robotikklinja/Flow-and-level-control/LWETankExample/lwe1/img/A18FD00E.png

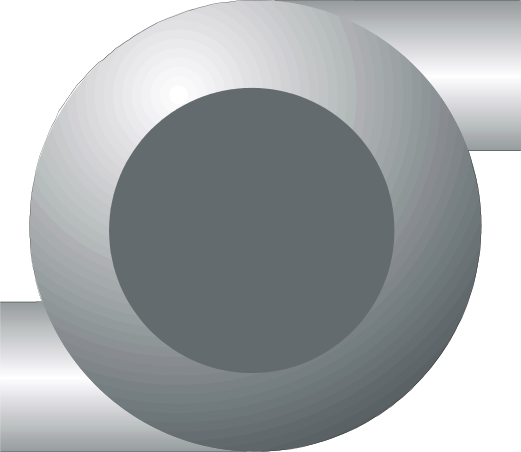
LWETankExample/lwe1/img/A18FD00E.png
