robotikklinja/Flow-and-level-control/LWETankExample/lwe1/img/EAA03FDC.png

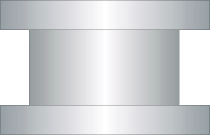
LWETankExample/lwe1/img/EAA03FDC.png
