robotikklinja/Flow-and-level-control/koblingsskjema_vann_stasjon.pdf

Projekttitel: Vann-stasjon | Sagsnr.: | Projektrev.: | Side 10
Kunde: Kuben VGS | DCC: | | Målestok: 1:1
Sidetitel: Forside | Tegningsnr.: | Siderev.: | Forrige side:
Filnavn: koblingsskjema_recovery | Konstr. (projekt/side): Jakob R | Sidst udskrevet: 07.03.2024 | Næste side: 20
Sideref.: | Godk. (dato/init): | Sidst rettet: 07.03.2024 | Antal sider ialt: 41

PCSCHEMATIC Automation

PCSCHEMATIC Automation Skoleversjon. Må ikke anvendes kommersielt.

# Vann-stasjon

# Vann-stasjon

# Special_Card side 250 - 250

# P&ID_Externt_etc side 300 - 301

# 10 Layout side 400 - 400

# Analog_Output

# Analog_Input

# Digital_Output

# Digital_Input

# Safety

# HMI

# Hovedstrøm_Fordeling

123456789

side 100 - 101

side 200 - 200

side 210 - 210

side 220 - 220

side 230 - 230

side 240 - 240

PCSCHEMATIC Automation Skoleversjon. Må ikke anvendes kommersielt.

# Vann-stasjon

# Graf Plan

Lister | 11
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
side 500 - 552

side 600 - 610

PCSCHEMATIC Automation Skoleversjon. Må ikke anvendes kommersielt.

Projekttitel: Vann-stasjon | Sagsnr.: | Projektrev.: | Side 30
Kunde: Kuben VGS | DCC: | | Målestok: 1:1
Indholdsfortegnelse
koblingsskjema_recovery | Jakob R | 07.03.2024 | 40
| | 14.12.2020 | 41

PCSCHEMATIC Automation

PCSCHEMATIC Automation Skoleversjon. Må ikke anvendes kommersielt.

Titel | Revision | Sidste rettelsestid | Sidenr. | Titel | Revision | Sidste rettelsestid | Sidenr.
| | | 40

100

101

200

210

220

230

Projektinfo

Hovedstrøm_Fordeling

Hovedfordeling

Fordeling

HMI

Safety

Digital_Input

Digital_Output

Analog_Input

28.03.2016 21:04:02

14.12.2020 09:54:18

25.09.2017 20:18:40

14.12.2020 09:25:04

14.12.2020 09:25:20

14.12.2020 09:25:04

25.09.2017 19:56:04

240

250

300

Analog_Output

Special_Card

P&ID_Externt_etc

P&ID_Prosesskjema

25.09.2017 19:56:12

25.09.2017 19:56:12

01.04.2016 09:41:30

301

400

500

510

Reguleringssløyfe

Layout

Arrangementstegning

Lister

Stykkliste (BOM-Liste, Bill Of Materials)

Komponentliste -B300..P300

28.03.2016 23:24:46

14.12.2020 09:27:34

14.12.2020 09:40:14

14.12.2020 09:40:14

Kabelliste | 28.03.2016 21:10:52 | 520
Rekkeklemmeliste Ekstern / Intern | 14.12.2020 09:26:10 | 530
PLS liste | 14.12.2020 09:26:10 | 540

550

600

610

Sidebemerkninger

Graf Plan

Tilordningsliste (Grafisk Klemplan)

Kabelplan

14.12.2020 10:00:56

28.03.2016 21:11:18

28.03.2016 21:11:28

Projekttitel: Vann-stasjon | Sagsnr.: | Projektrev.: | Side 40
Kunde: Kuben VGS | DCC: | | Målestok: 1:1
Projektinfo
28.03.2016 | 41 PCSCHEMATIC Automation

PCSCHEMATIC Automation Skoleversjon. Må ikke anvendes kommersielt.

### Projektinfo

Her er der plads til at beskrive forskellige udgangspunkter for projektet.

### Bemærkninger

### Referencebetegnelser

### Dedikerede lederfarver for forskellige potentialer/signaler Navngivning og nummerering Opmærkning af komponenter, kabler og ledninger Stregtyper Referencebetegnelser

og meget andet ...

# Hovedstrøm_Fordeling

### - 102 Side 100

PCSCHEMATIC Automation Skoleversjon. Må ikke anvendes kommersielt.

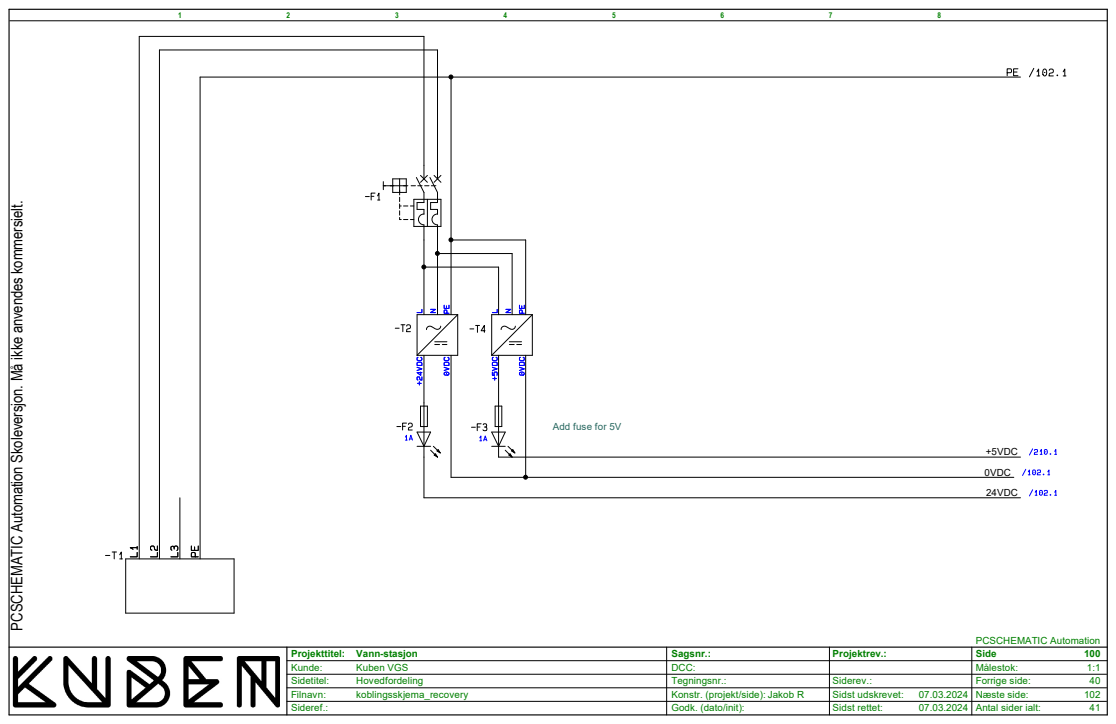
[picture p3: page 7]
PCSCHEMATIC Automation; 24VDC; 0VDC; +5VDC

PCSCHEMATIC Automation Skoleversjon. Må ikke anvendes kommersielt. 1 2

Add fuse for 5V

Projekttitel: Vann-stasjon | Sagsnr.: | Projektrev.: | Side 100
Kunde: Kuben VGS | DCC: | | Målestok: 1:1

Hovedfordeling

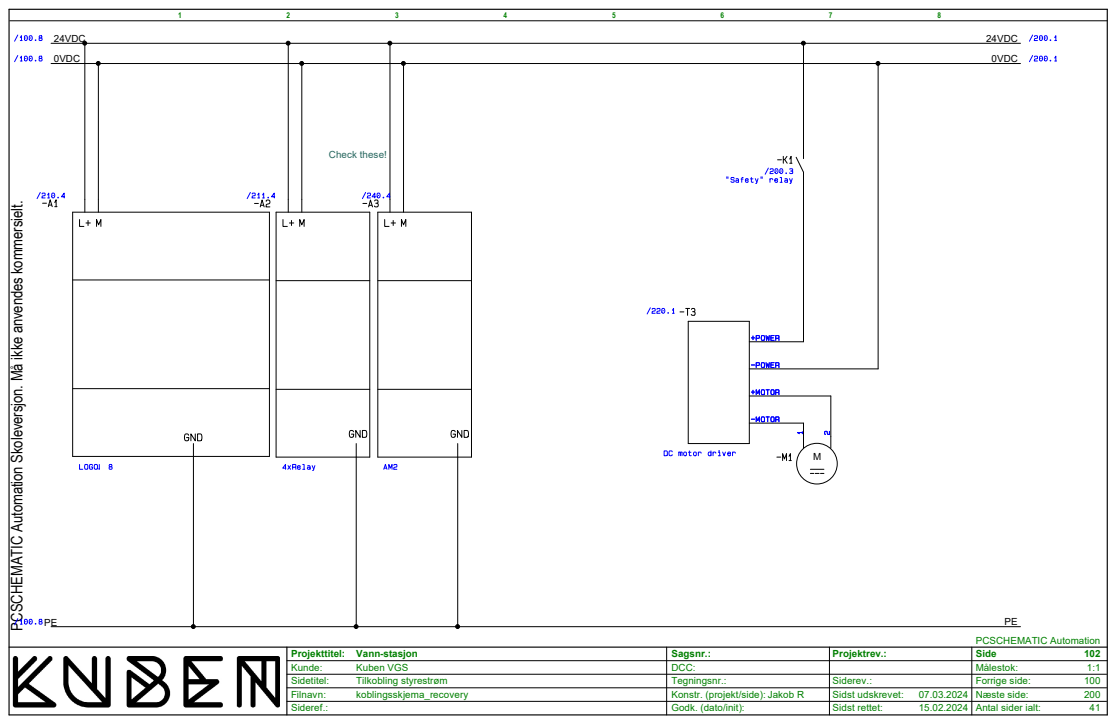
[picture p4: page 8]
PCSCHEMATIC Automation; 24VDC; 0VDC; Check these!

PCSCHEMATIC Automation Skoleversjon. Må ikke anvendes kommersielt. 1 2

Projekttitel: Vann-stasjon | Sagsnr.: | Projektrev.: | Side 102
Kunde: Kuben VGS | DCC: | | Målestok: 1:1

Tilkobling styrestrøm

# HMI

PCSCHEMATIC Automation Skoleversjon. Må ikke anvendes kommersielt.

# Safety

### - 200 Side 200

PCSCHEMATIC Automation Skoleversjon. Må ikke anvendes kommersielt.

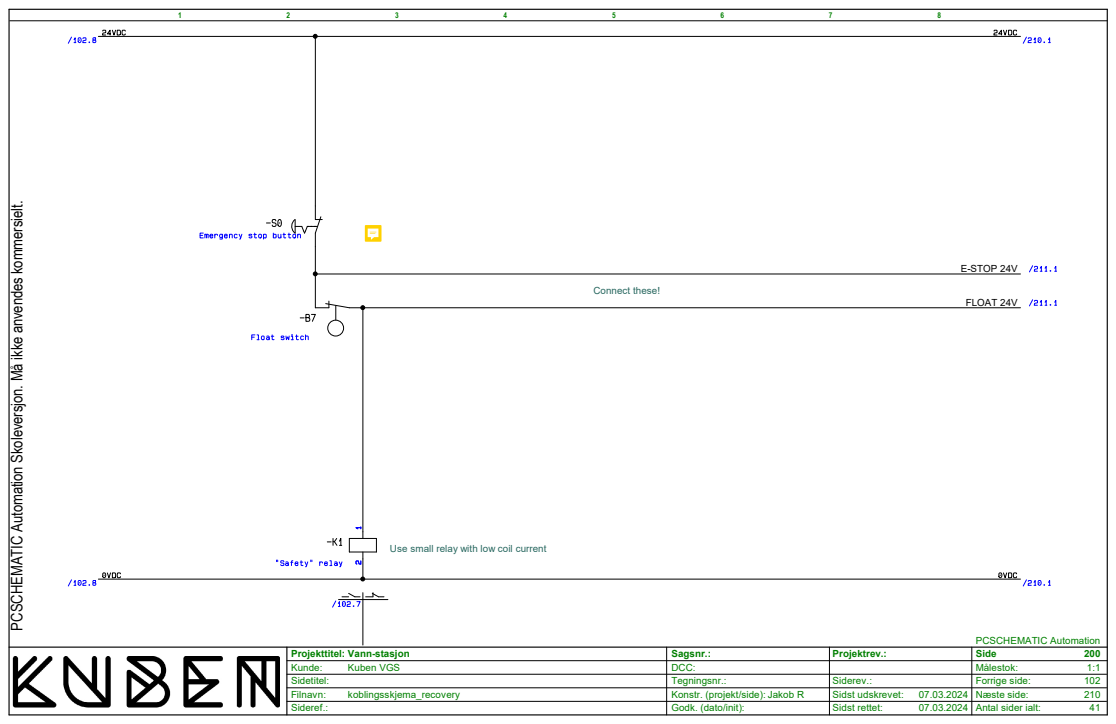
[picture p5: page 11]
PCSCHEMATIC Automation; E-STOP 24V; FLOAT 24V; Connect these!

PCSCHEMATIC Automation Skoleversjon. Må ikke anvendes kommersielt. 1 2

Use small relay with low coil current

Projekttitel: Vann-stasjon | Sagsnr.: | Projektrev.: | Side 200
Kunde: Kuben VGS | DCC: | | Målestok: 1:1

# Digital_Input

### - 211 Side 210

PCSCHEMATIC Automation Skoleversjon. Må ikke anvendes kommersielt.

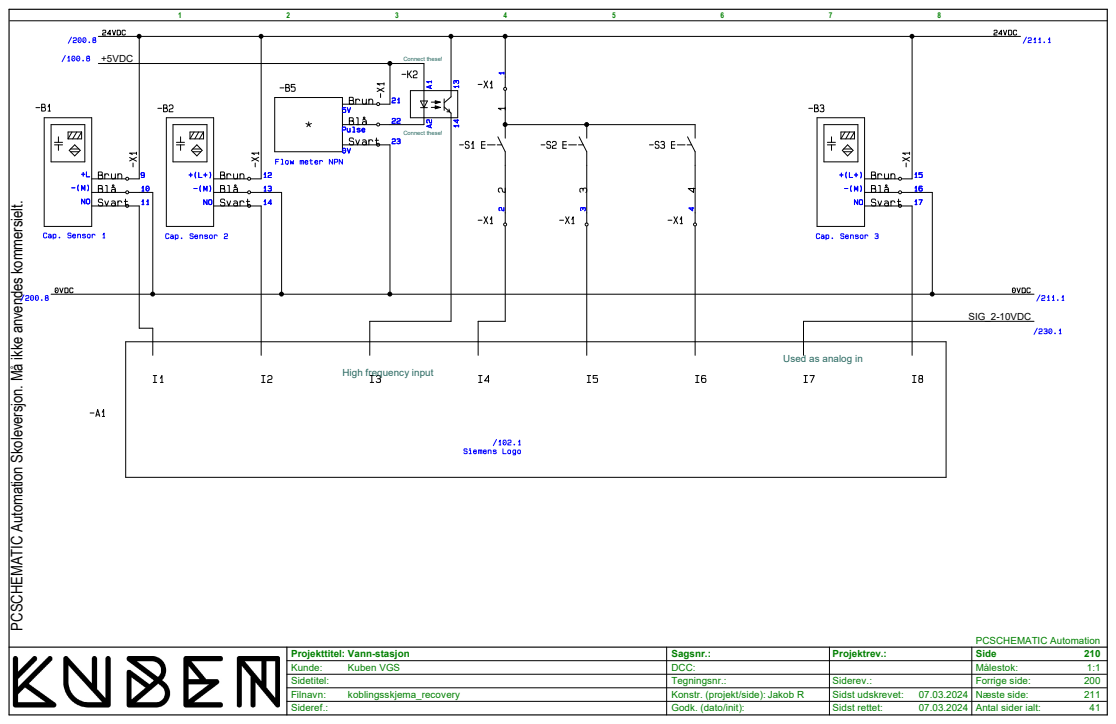
[picture p6: page 13]
PCSCHEMATIC Automation; SIG_2-10VDC; +5VDC; Connect these!

PCSCHEMATIC Automation Skoleversjon. Må ikke anvendes kommersielt. 1 2

Used as analog in

High frequency input

Projekttitel: Vann-stasjon | Sagsnr.: | Projektrev.: | Side 210
Kunde: Kuben VGS | DCC: | | Målestok: 1:1

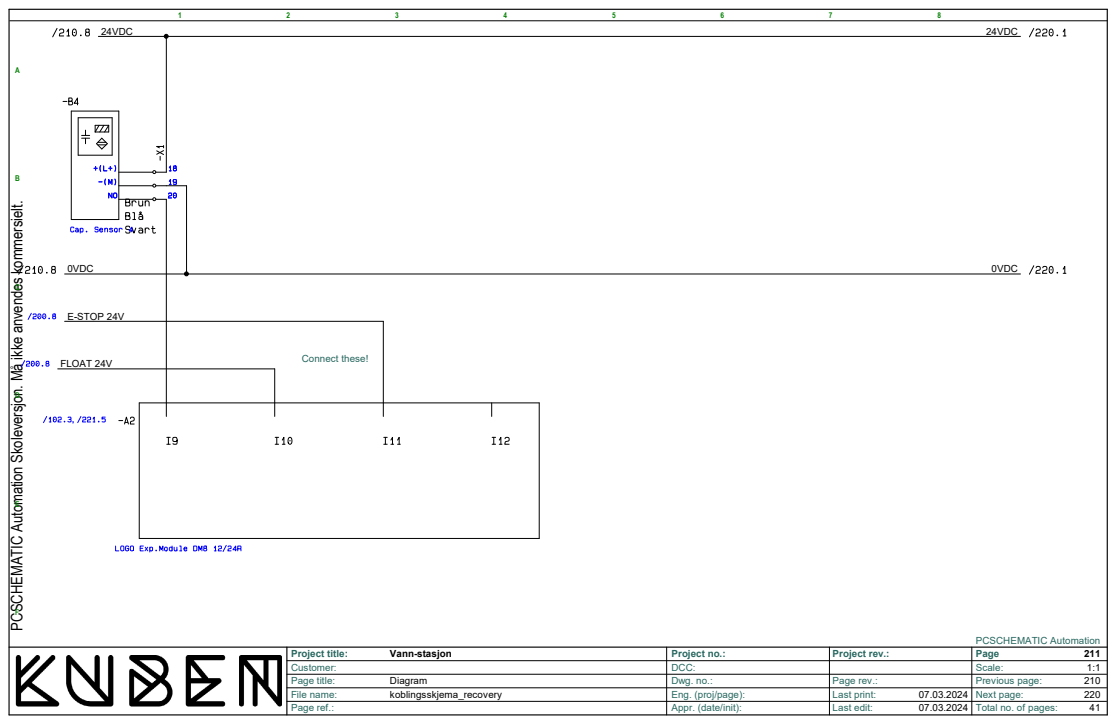
[picture p7: page 14]
PCSCHEMATIC Automation; ABCDEF; 24VDC; 0VDC; FLOAT 24V; E-STOP 24V; Connect these!

PCSCHEMATIC Automation Skoleversjon. Må ikke anvendes kommersielt. 1 2

Project title: Vann-stasjon | Project no.: | Project rev.: | Page 211
Customer: | DCC: | | Scale: 1:1
Page title: Diagram | Dwg. no.: | Page rev.: | Previous page:
File name: | Eng. (proj/page): | Last print: | Next page:
Page ref.: | Appr. (date/init): | Last edit: 07.03.2024 | Total no. of pages: 41

# Digital_Output

### - 221 Side 220

PCSCHEMATIC Automation Skoleversjon. Må ikke anvendes kommersielt.

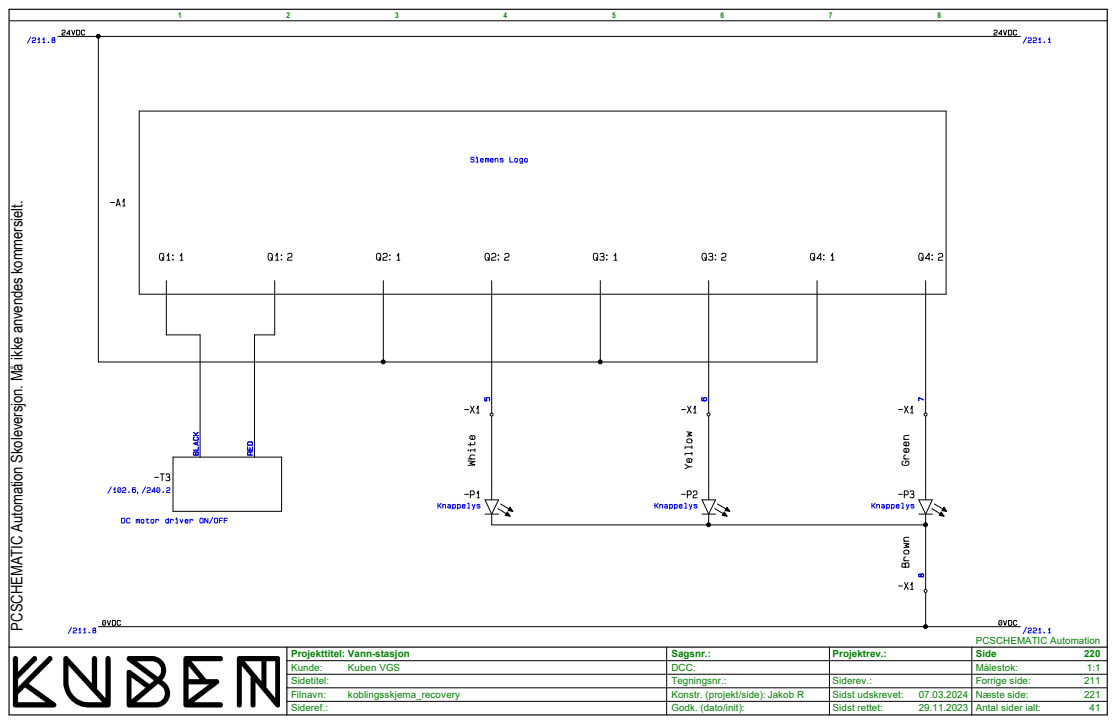
[picture p8: page 16]
PCSCHEMATIC Automation

PCSCHEMATIC Automation Skoleversjon. Må ikke anvendes kommersielt. 1 2

Projekttitel: Vann-stasjon | Sagsnr.: | Projektrev.: | Side 220
Kunde: Kuben VGS | DCC: | | Målestok: 1:1

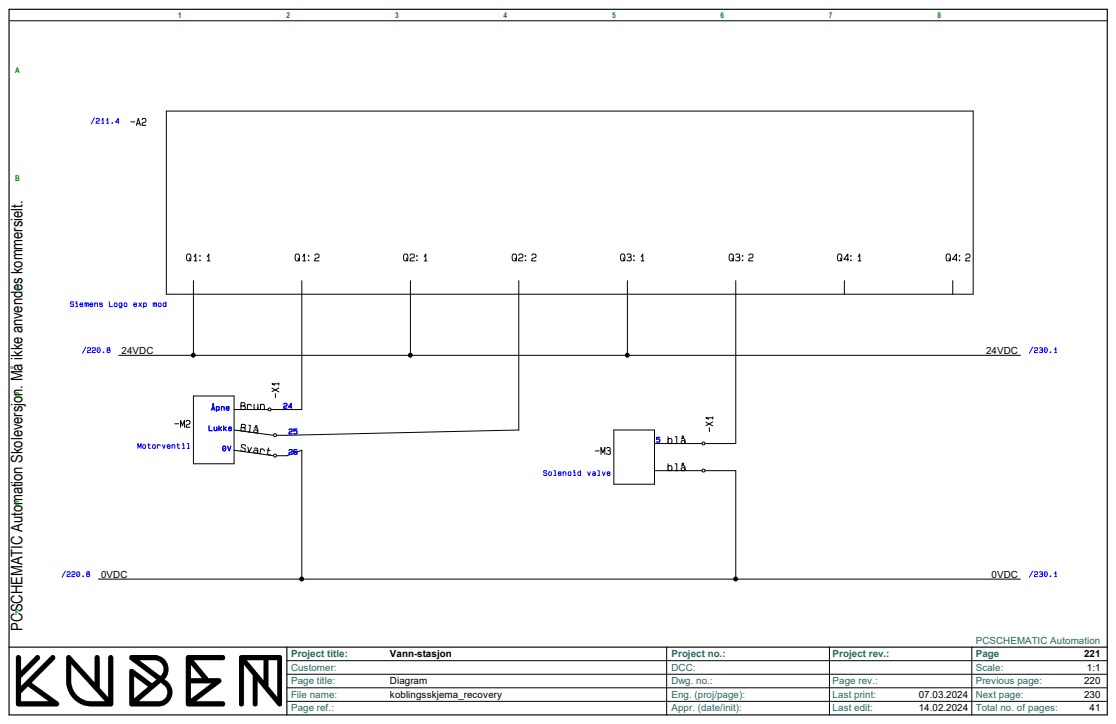
[picture p9: page 17]
PCSCHEMATIC Automation; ABCDEF; 24VDC; 0VDC

PCSCHEMATIC Automation Skoleversjon. Må ikke anvendes kommersielt. 1 2

Project title: Vann-stasjon | Project no.: | Project rev.: | Page 221
Customer: | DCC: | | Scale: 1:1
Page title: Diagram | Dwg. no.: | Page rev.: | Previous page:
File name: | Eng. (proj/page): | Last print: | Next page:
Page ref.: | Appr. (date/init): | Last edit: 14.02.2024 | Total no. of pages: 41

# Analog_Input

### - 230 Side 230

PCSCHEMATIC Automation Skoleversjon. Må ikke anvendes kommersielt.

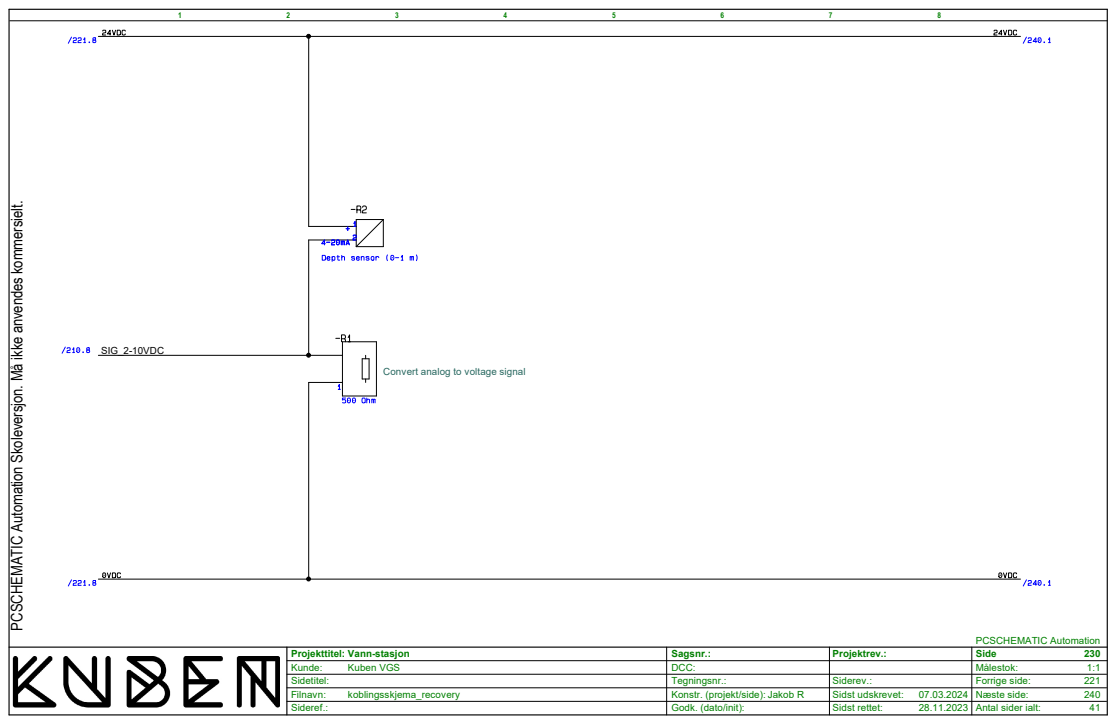
[picture p10: page 19]
PCSCHEMATIC Automation; SIG_2-10VDC

PCSCHEMATIC Automation Skoleversjon. Må ikke anvendes kommersielt. 1 2

Convert analog to voltage signal

Projekttitel: Vann-stasjon | Sagsnr.: | Projektrev.: | Side 230
Kunde: Kuben VGS | DCC: | | Målestok: 1:1

# Analog_Output

### - 240 Side 240

PCSCHEMATIC Automation Skoleversjon. Må ikke anvendes kommersielt.

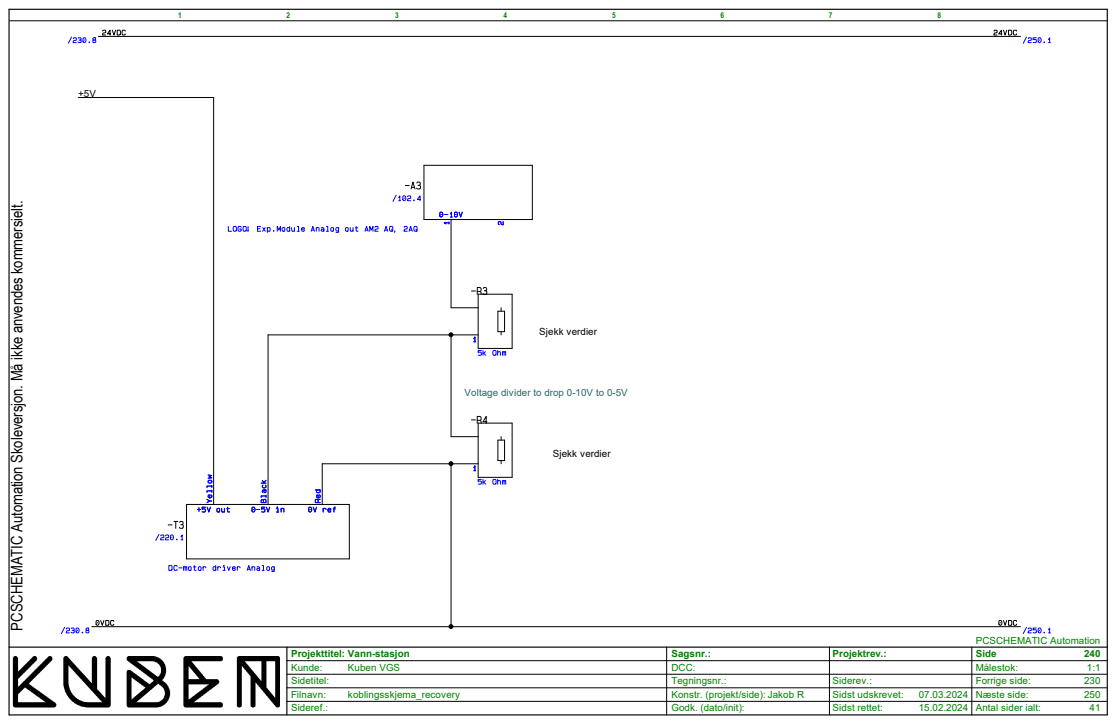
[picture p11: page 21]
PCSCHEMATIC Automation; Sjekk verdier

PCSCHEMATIC Automation Skoleversjon. Må ikke anvendes kommersielt. 1 2

Voltage divider to drop 0-10V to 0-5V

Projekttitel: Vann-stasjon | Sagsnr.: | Projektrev.: | Side 240
Kunde: Kuben VGS | DCC: | | Målestok: 1:1

# Special_Card

### - 250 Side 250

PCSCHEMATIC Automation Skoleversjon. Må ikke anvendes kommersielt.

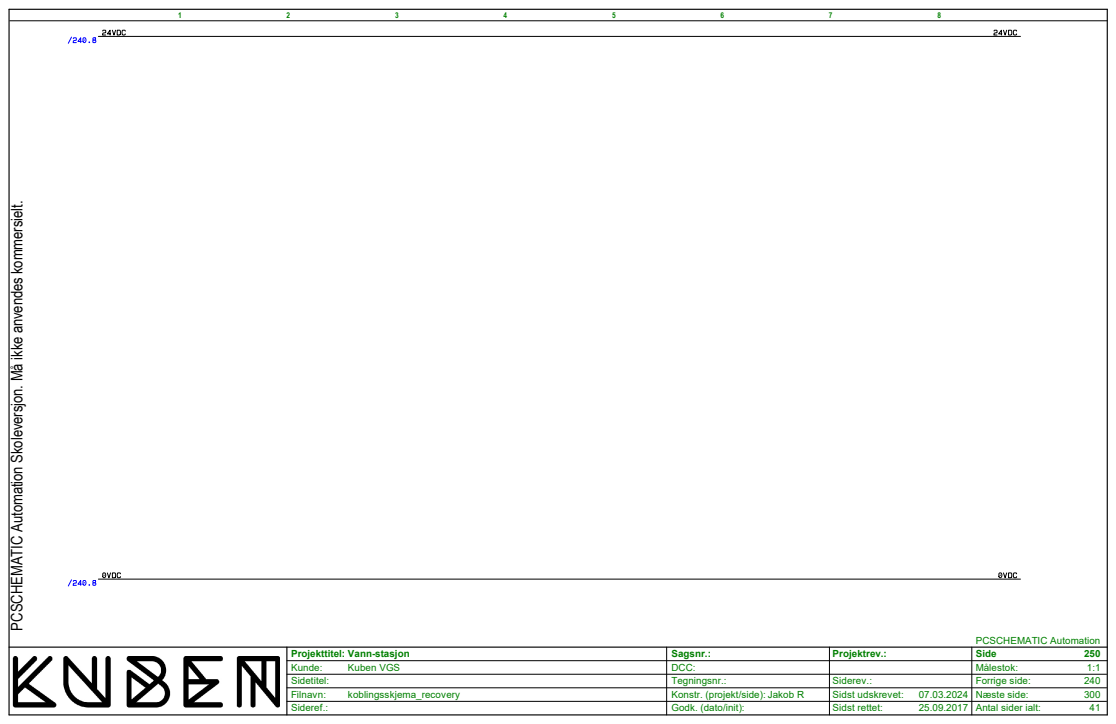
[picture p12: page 23]
PCSCHEMATIC Automation

PCSCHEMATIC Automation Skoleversjon. Må ikke anvendes kommersielt. 1 2

Projekttitel: Vann-stasjon | Sagsnr.: | Projektrev.: | Side 250
Kunde: Kuben VGS | DCC: | | Målestok: 1:1

# P&ID_Externt_etc

### - 301 Side 300

PCSCHEMATIC Automation Skoleversjon. Må ikke anvendes kommersielt.

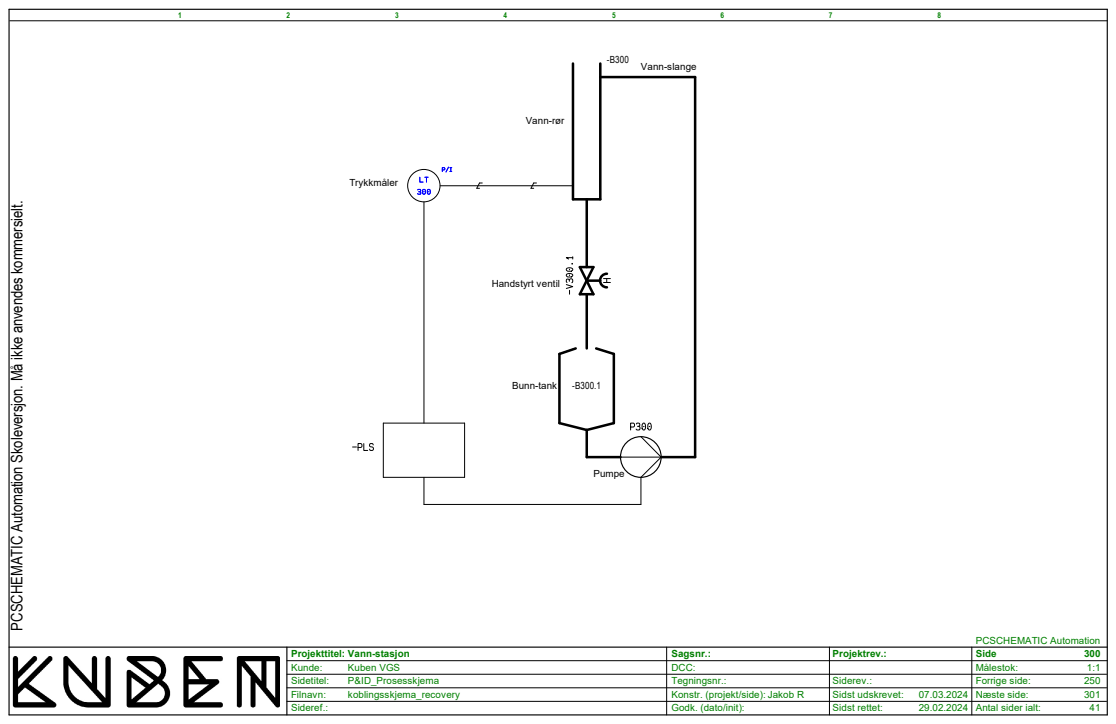
[picture p13: page 25]
PCSCHEMATIC Automation; Bunn-tank; Vann-rør; Trykkmåler; Handstyrt ventil; Vann-slange; Pumpe

PCSCHEMATIC Automation Skoleversjon. Må ikke anvendes kommersielt. 1 2

Projekttitel: Vann-stasjon | Sagsnr.: | Projektrev.: | Side 300
Kunde: Kuben VGS | DCC: | | Målestok: 1:1

P&ID_Prosesskjema

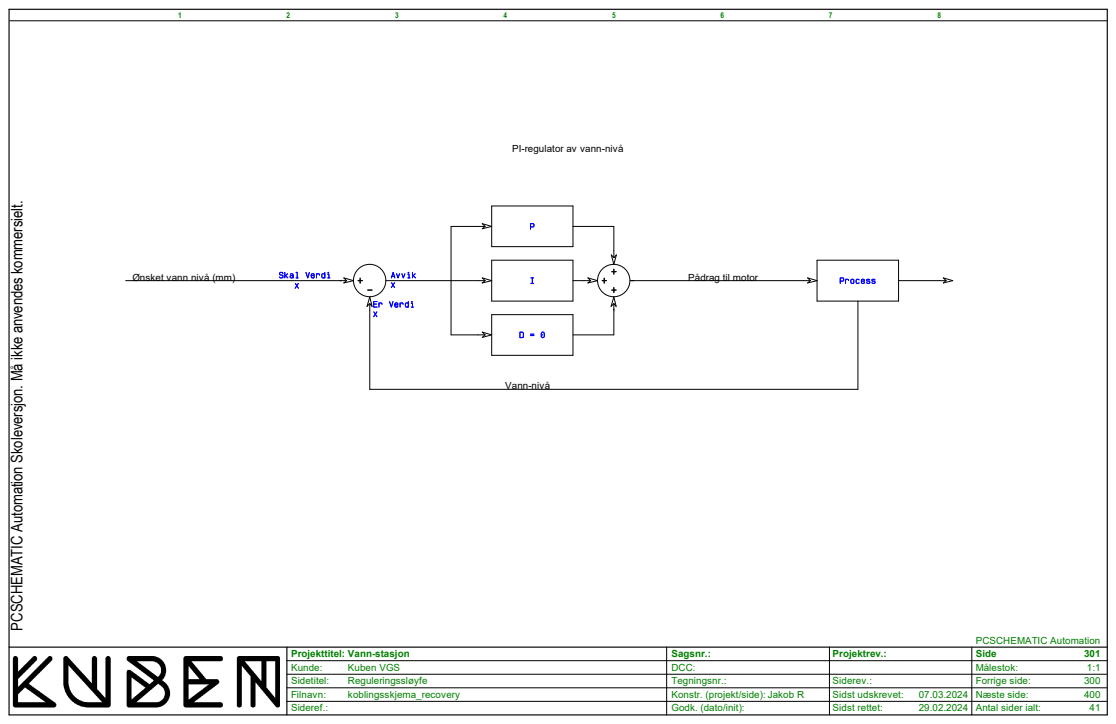
[picture p14: page 26]
PCSCHEMATIC Automation; Vann-nivå; Ønsket vann nivå (mm); Pådrag til motor

PI-regulator av vann-nivå

PCSCHEMATIC Automation Skoleversjon. Må ikke anvendes kommersielt.

Projekttitel: Vann-stasjon | Sagsnr.: | Projektrev.: | Side 301
Kunde: Kuben VGS | DCC: | | Målestok: 1:1

Reguleringssløyfe
