robotikklinja/Flow-and-level-control/LWETankExample/lwe1/img/2D491AB6.png

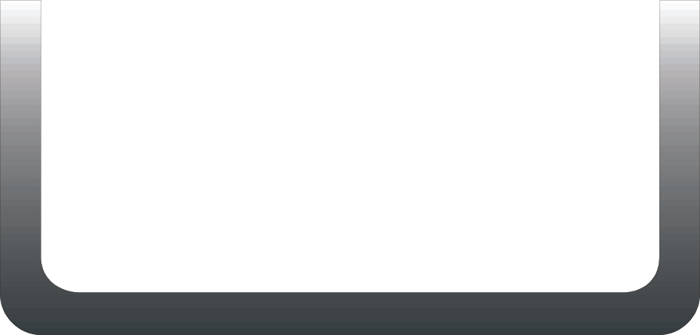
LWETankExample/lwe1/img/2D491AB6.png
