robotikklinja/Flow-and-level-control/LWETankExample/lwe1/img/38A8DEAD.png

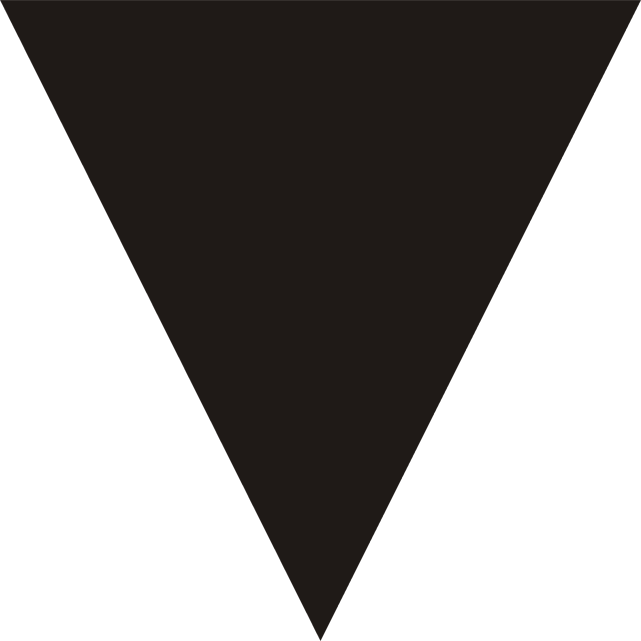
LWETankExample/lwe1/img/38A8DEAD.png
