robotikklinja/Flow-and-level-control/3D_prints/Valve_latch_main.stl

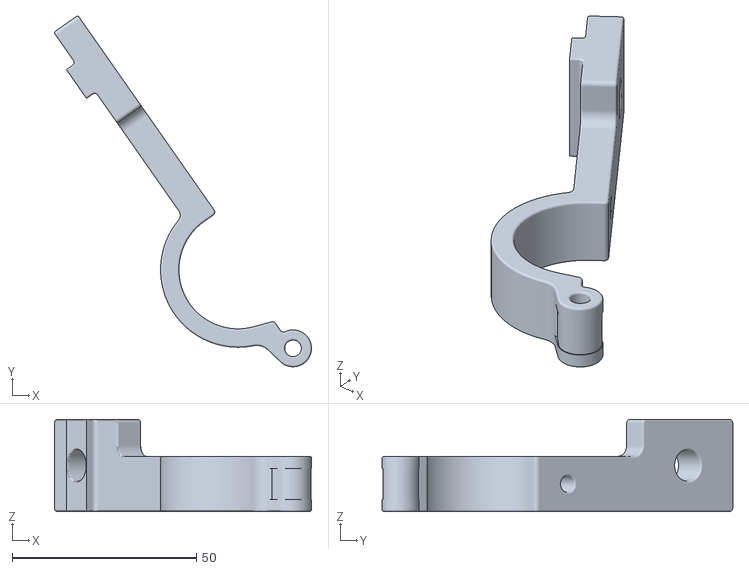
[picture p17: CAD file, 2023-11-13]
3D_prints/Valve_latch_main.stl
69.7 x 95.0 x 25.0
