robotikklinja/Flow-and-level-control/Sensor holder fløde regulering v1.stl

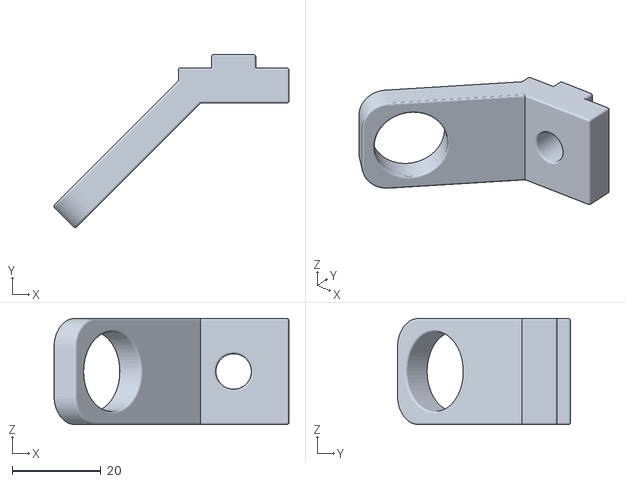
[picture p18: CAD file, 2023-11-13]
Sensor holder fløde regulering v1.stl
53.1 x 39.1 x 24.0
