robotikklinja/Flow-and-level-control/3D_prints/valve_latch_gate.stl

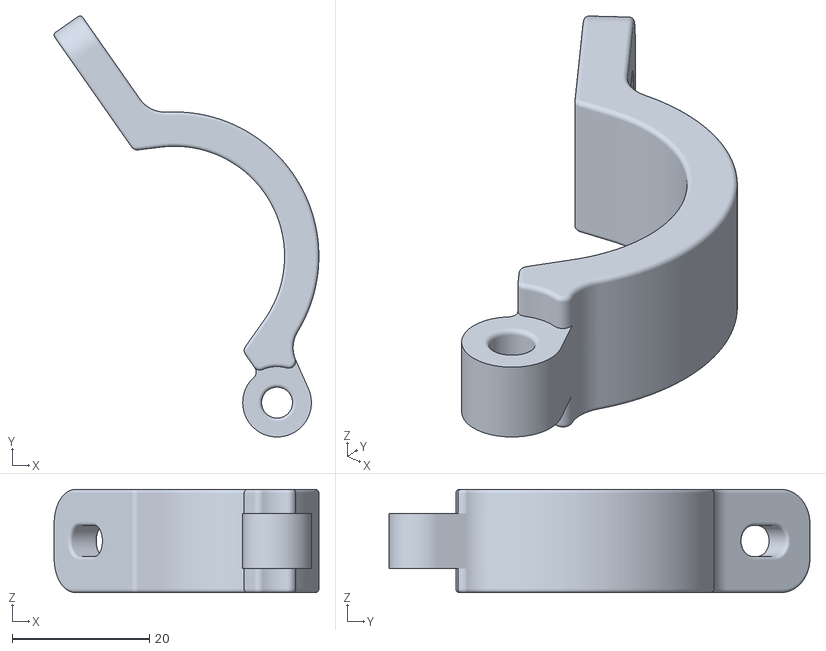
[picture p19: CAD file, 2023-11-09]
3D_prints/valve_latch_gate.stl
38.5 x 61.3 x 15.0
