robotikklinja/Flow-and-level-control/3D_prints/tube_holder_upper_base.stl

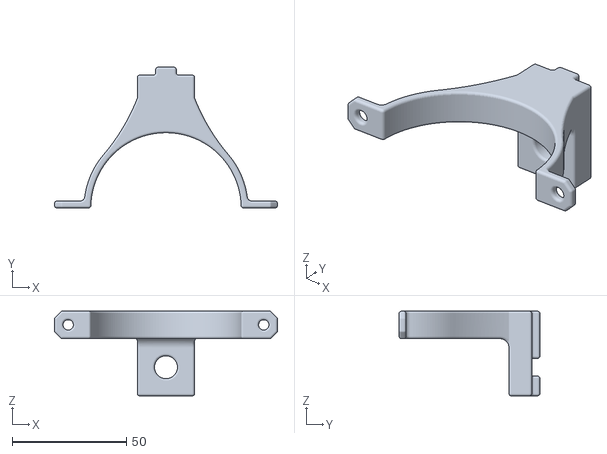
[picture p20: CAD file, 2023-11-03]
3D_prints/tube_holder_upper_base.stl
97.4 x 61.5 x 37.0
