robotikklinja/Flow-and-level-control/3D_prints/Grill.stl

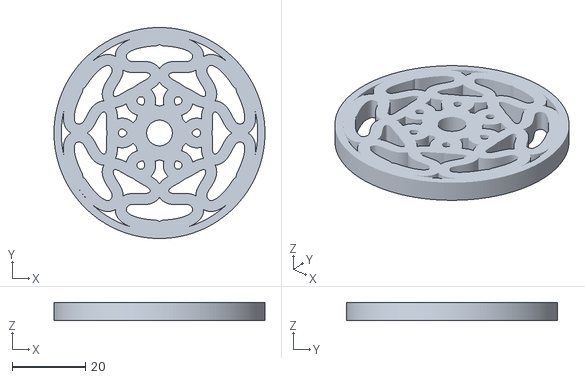
[picture p21: CAD file, 2023-11-03]
3D_prints/Grill.stl
57.5 x 57.5 x 5.00
