robotikklinja/Flow-and-level-control/3D_prints/Tube_holde.stl

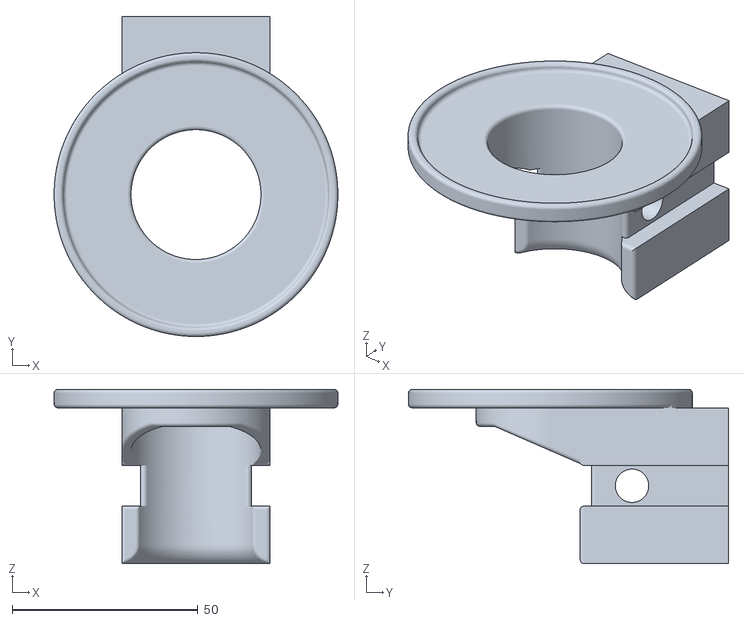
[picture p22: CAD file, 2023-11-03]
3D_prints/Tube_holde.stl
76.5 x 86.2 x 47.0
