robotikklinja/Flow-and-level-control/3D_prints/tube_holder_upper_ring.stl

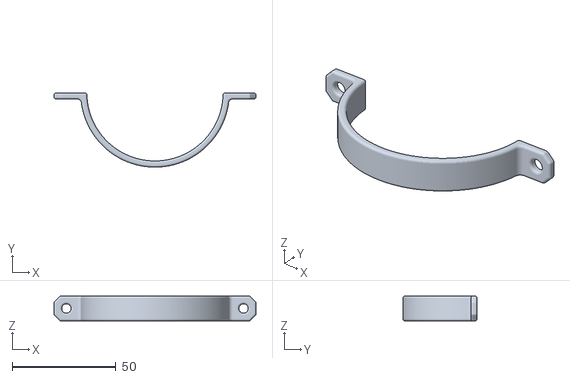
[picture p23: CAD file, 2023-11-03]
3D_prints/tube_holder_upper_ring.stl
97.4 x 35.8 x 12.0
