robotikklinja/Flow-and-level-control/3D_prints/nut_for_cabinet.stl

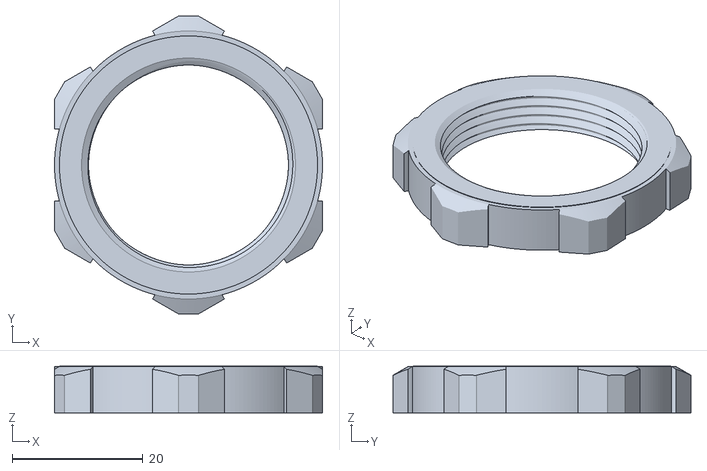
[picture p24: CAD file, 2023-11-13]
3D_prints/nut_for_cabinet.stl
41.0 x 45.6 x 7.18
