robotikklinja/Flow-and-level-control/(list of files, cad)

Other CAD files:
3D_prints/Stasjon_tube_holder v2.f3d
3D_prints/Stasjon_tube_holder_upper v1.f3d
3D_prints/simplified_backet_for_print v2.f3d
