robotikklinja/Flow-and-level-control/(commit log)

2023-11-03 3d models upload
    [Grill.stl, Stasjon_tube_holder v2.f3d, Stasjon_tube_holder_upper v1.f3d, Tube_holde.stl, simplified_backet_for_print v2.f3d, tube_holder_upper_base.stl, tube_holder_upper_ring.stl]
2023-11-09 valve holder
    [Valve_latch_main.stl, valve_latch_gate.stl]
2023-11-13 more stl
    [Valve_latch_main.stl, nut_for_cabinet.stl]
2023-11-13 more stl 2
    [Sensor holder fløde regulering v1.stl]
2023-11-15 Added BOM and notes
2024-11-21 Added school files
    [Data.xlsx, Linjer_kompensasjon.xlsx, PID_regulering_closed_loop.xlsx, Sensor holder fløde regulering v1.stl]
